henning2323/IR_LightGun/(threads)

Thread 1 (2023-01-18):

Position not being updated and warning LED always on

Jaensche, 2023-01-18:
Hi Henning

Let me first start by congratulating you on this very cool project! :-) I immediately had to disassemble a NERF Firestrike (seems to be a good case for all the components and easy to take apart). I was able to put the code on my Leonardo clone (https://wiki.dfrobot.com/Beetle_SKU_DFR0282, even smaller then the pico). And the mouse buttons and the warning LED worked out of the box.

Now to the problem:
I don't get any mouse movements and the warning LED is always on. The connection of the IR sensor should be OK as the the ports are labeled SCL and SDA. Also the LED on the sensor shines bright red. Would the warning always be on if the sensor does not see any IR sources?
I have 4 IR LEDs positioned in the corners of my screen. They are probably not very bright but i would have expected to seem at least some movement.

Any ideas what i could try/test?

Thanks
Jan

Jaensche, 2023-01-20:
Small update: I added some serial debug messages and discovered that it actually does track some IR sources but very rarely all 4 of them. Now i am planning to move the IR sources further away so they can be seen with the limited tracking angle of the device. Also i want to reduce the resistor before each IR LED (from 220 to maybe 80?) to drive them a bit more and get more light.

henning2323, 2023-01-20:
Hi Jaensche,
the warning LED always lights up when fewer than 4 LEDs are found and also the mouse position won't be updated. Printing out the sensor data would have also been my first suggestion. Depending on your LEDs it can sometimes be tricky to get good visibility. IR LEDs tend to be very directional and are barely visible even from rather slight angles. The best thing is LED Arrays where each corner has multiple LEDs which are pointed at slightly different angles (I think you can see an example of this in my instructions). Otherwise you could try to roughen the surface of the LEDs with sandpaper or even cut/sand the tips flat. You could also experiment with reflectors but I think it will be hard to achieve a robust solution with this.

Lowering the Resistance can help a lot. It's hard to say for sure when the LED will break. I think you have to experiment a little to find the highest light output and probably kill some LEDs in the process. I hope you have some spares 😄

Thanks for trying out my project and I'd love to get an update on how it's going!

Cheers,
Henning

Jaensche, 2023-01-22:
Hi Henning

Thanks for taking the time to answer. In the meantime i had some success by driving the LEDs with a bit more current and moving further away from the screen / LEDs. Finally the warning LED is off and i can move the cursor on the screen. I guess i was just to close for the narrow angle the sensor can track IR sources in.
Now something odd is happening though. When i hold the sensor in the way that is indicated (its labeled TOP on the top) the mouse movement is turned by 90 degrees. So when i move up and down the cursor moves sideways. Not a big deal as i can just mount the sensor turned as well but i was wondering if you noticed the same thing.

Cheers
Jan

henning2323, 2023-01-22:
As you mention that, I remember noticing the same thing. The label on the IR Sensor is misorientated or you could say the sensor puts out the coordinates in an unusual order (first y then x). I also fixed that by rotating the sensor.
I'm glad you got it working :)
May I ask for a picture of your finished build? I'm curious how yours turned out.

Cheers,
Henning

Jaensche, 2023-01-25:
Was finally able to play some Time Crisis on a PSX emulator. Worked OK after filing the LEDs flat (as suggested in your text). But the whole thing is still a bit unreliable. In the corners of the screen the cursor starts to judder and jumps around a lot. And sometimes i also cannot get a lock on the 4 LEDs at all. Not sure whats causing that. I will for sure invest in some stronger LEDs in the future. Do you know if the IR light gets dangerous at some point? In this setup one is directly looking into them, right?
I will attach some pictures of the converted NERF Firestrike soon. Whats cool about this one is that it has integrated light that i am using now for indicating a shot. Also it has a second small trigger that i repurposed as the second button (e.g. cover/uncover in Time Crisis).

Cheers
Jan

akeilox, 2023-04-27:
hey @Jaensche can you share a picture of converted NERF Firestrike?
Interested how internals fitted n overall look

Jaensche, 2023-04-27:
Here you go!

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

Other firmware you can try:
https://github.com/samuelballantyne/IR-Light-Gun
https://github.com/gobozgz/GUN4IR

Cheers
Jeansche

Thread 2 (2023-05-07):

Is it possible to reduce the distance of use by adjusting the angle of the leds?

TeamARV, 2023-05-07:
Hi henning2323, first I wanted to thank you for sharing the code.

Seeing that there was a free code option, I was encouraged and built my weapon following his instructions and adjusting the buttons to my needs.

I got everything to work BUT I have to use from 1.8 Mts away.

I wanted to know if it is possible to reduce this distance by adjusting the position of the emitting LEDs?
Currently I have 12 LEDs, 3 on each side.

In his photos I saw that he has them diagonally in the corners

it´s me leds config
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

This is the cheapest nerf gun I found to mod,
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

Two buttons on the front, the trigger and I use the top movable carriage to manually reload by shaking hard or swinging it so it hits a limit switch.

Thanks again for the code and I hope you continue to improve it.

henning2323, 2023-05-07:
Hi Andrés,
first of all, thank you for enjoying my project.
The 1.8 meters you mentioned match the distance where the LEDs cannot be seen by the camera anymore with your screen size. This is because of its limited viewing angle. Improving the LEDs won't help you with this problem. If you want to get closer to the screen, you need to add some kind of wide angle lense infront of the camera. But such a lense adds distortion to the camera which could mess up the positioning. Maybe I find some time in the next half year to experiment a little with lenses. If so, I'll keep you updated.
But feel free to so so on your own, if you want to :)

henning2323, 2023-05-07:
I have an idea on how it could be possible to bring the distance down by ~40% by adjusting only the LED positions. I will probably have time to look into the viability of that idea within the next month.

akeilox, 2023-05-08:
@TeamARV do you have pictures of the nerf internal that you can share? Curious about components n fitting.

which LEDs did you use? I cant seem to get above 25 degree angle IR diodes

TeamARV, 2023-05-09:
@akeilox I used 4 arrangements of 3 leds placed on some terminal blocks attached with velcro to the screen
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

     DC Current(Nominal): 20mA.
     DC Current(Max): 100mA.
     Forward voltage: 1.2V-1.6V.
     Power dissipation: 150mW.
     Radiant intensity: 3.31 mW/sr at 20mA.
     Wavelength: 940nm.
     Viewing angle: 40°.
     Operating temperature: -40°C ~ 85°C.
     Encapsulation: T-1 3/4 (5mm).
     Replacement: LTE5208A.

And connect them like this
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
sorry i did not take pictures of the internal trim but there is good space in this nerf model.

-------------------------------------------------------------------------------------------------------------------------------------

@henning2323 Searching I found other projects where they use a 180° fish eye lens to use closer, I managed to adjust a lens and it worked fine now 1.10m~1.2m is playable.
