henning2323/IR_LightGun/(commit log)

2022-11-29 added wiring diagram
2022-11-29 inserted all images
